Gorloth/all_yout_base_clock_control_board/control_board.kicad_pcb

## KiCad design control_board.kicad_pcb (2019-01-07)

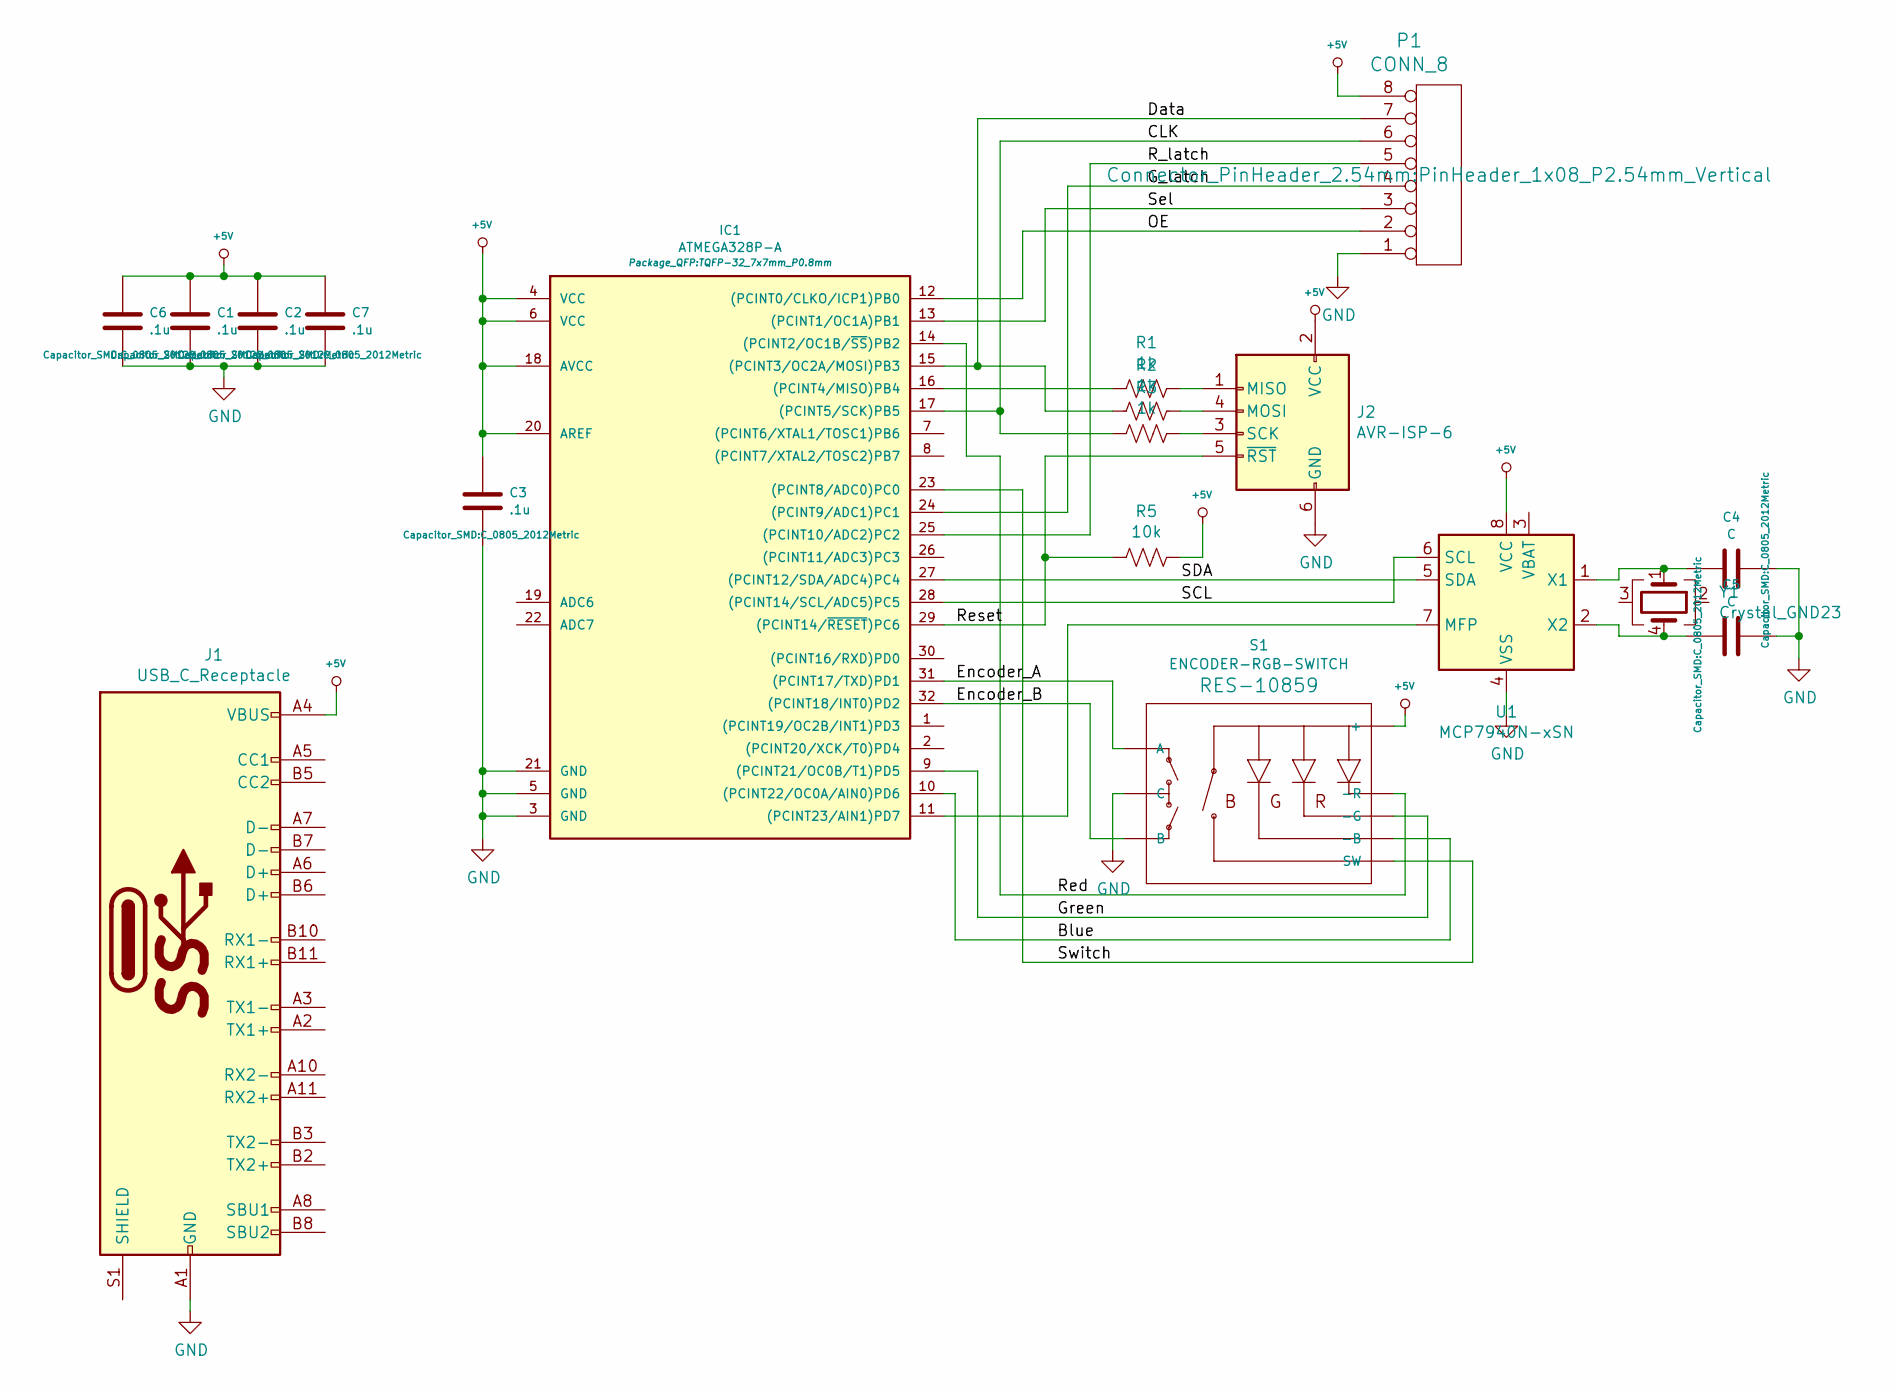
[picture p1: schematic control_board.sch]

Parts:
C1, C2, C3, C6, C7: .1u; C_0805_2012Metric
C4, C5: C; C_0805_2012Metric
IC1: ATMEGA328P-A; TQFP-32_7x7mm_P0.8mm
J1: USB_C_Receptacle; JAE_DX07S024XJ1R1100
J2: AVR-ISP-6; PinHeader_2x03_P2.54mm_Vertical
P1: CONN_8; PinHeader_1x08_P2.54mm_Vertical
R1, R2, R3: 1k; R_0805_2012Metric
R5: 10k; R_0805_2012Metric
S1: ENCODER-RGB-SWITCH; Encoder_w_switch_RGB_LED_SMD
U1: MCP7940N-xSN; SSOP-8_3.95x5.21x3.27mm_P1.27mm
Y1: Crystal_GND23; Crystal_SMD_SeikoEpson_MC146-4Pin_6.7x1.5mm_HandSoldering

Connections:
+5V: C1.1, C2.1, C3.1, C6.1, C7.1, IC1.4 (VCC), IC1.6 (VCC), IC1.18 (AVCC), IC1.20 (AREF), J1.A4 (VBUS), J1.A9 (VBUS), J1.B4 (VBUS), J1.B9 (VBUS), J2.2 (VCC), P1.8, R5.1, S1.5 (+), U1.8 (VCC)
/Blue: IC1.10 ((PCINT22/OC0A/AIN0)PD6), S1.4 (-B)
/CLK: IC1.17 ((PCINT5/SCK)PB5), P1.6, R3.2
/Data: IC1.15 ((PCINT3/OC2A/MOSI)PB3), P1.7, R2.2
/Encoder_A: IC1.31 ((PCINT17/TXD)PD1), S1.A
/Encoder_B: IC1.32 ((PCINT18/INT0)PD2), S1.B
/G_latch: IC1.24 ((PCINT9/ADC1)PC1), P1.4
/Green: IC1.9 ((PCINT21/OC0B/T1)PD5), S1.2 (-G)
/OE: IC1.12 ((PCINT0/CLKO/ICP1)PB0), P1.2
/R_latch: IC1.25 ((PCINT10/ADC2)PC2), P1.5
/Red: IC1.14 ((PCINT2/OC1B/~SS~)PB2), S1.1 (-R)
/Reset: IC1.29 ((PCINT14/~RESET~)PC6), J2.5 (~RST), R5.2
/SCL: IC1.28 ((PCINT14/SCL/ADC5)PC5), U1.6 (SCL)
/SDA: IC1.27 ((PCINT12/SDA/ADC4)PC4), U1.5 (SDA)
/Sel: IC1.13 ((PCINT1/OC1A)PB1), P1.3
/Switch: IC1.23 ((PCINT8/ADC0)PC0), S1.3 (SW)
GND: C1.2, C2.2, C3.2, C4.2, C5.1, C6.2, C7.2, IC1.3 (GND), IC1.5 (GND), IC1.21 (GND), J1.A1 (GND), J1.A12 (GND), J1.B1 (GND), J1.B12 (GND), J2.6 (GND), P1.1, S1.C, U1.4 (VSS)
unnamed: C4.1, U1.1 (X1), Y1.1
unnamed: C5.2, U1.2 (X2), Y1.4
unnamed: IC1.11 ((PCINT23/AIN1)PD7), U1.7 (MFP)
unnamed: IC1.16 ((PCINT4/MISO)PB4), R1.2
unnamed: J2.1 (MISO), R1.1
unnamed: J2.3 (SCK), R3.1
unnamed: J2.4 (MOSI), R2.1

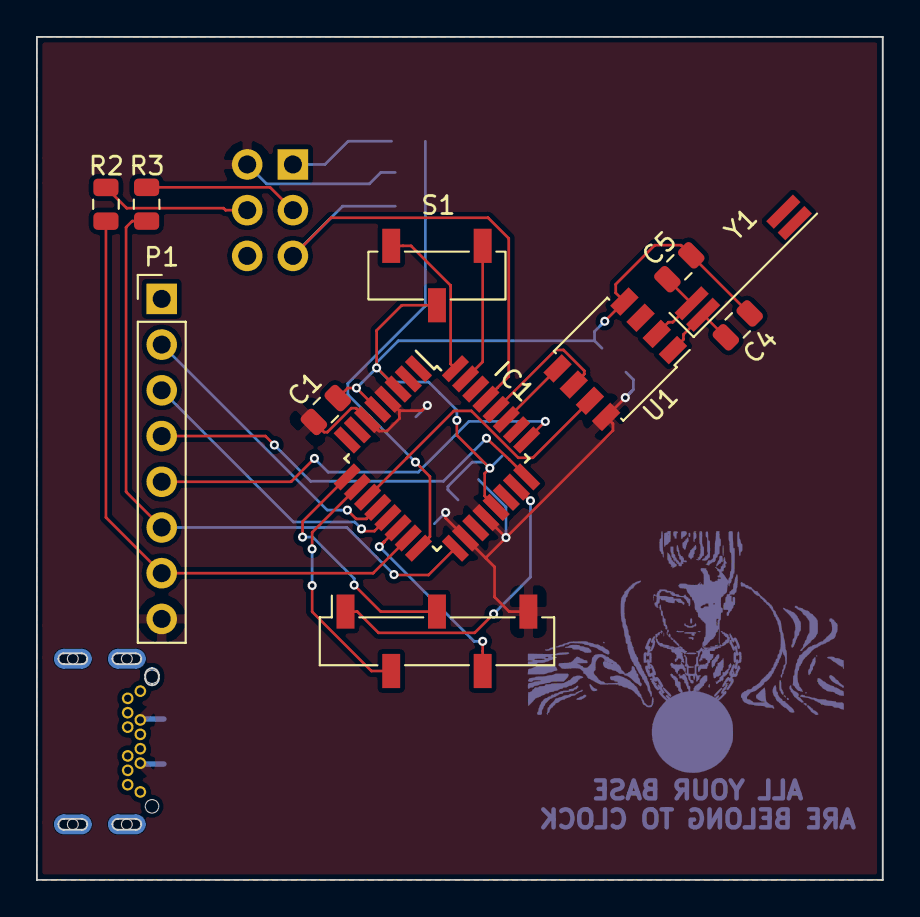
[picture p2: board control_board.kicad_pcb from above]

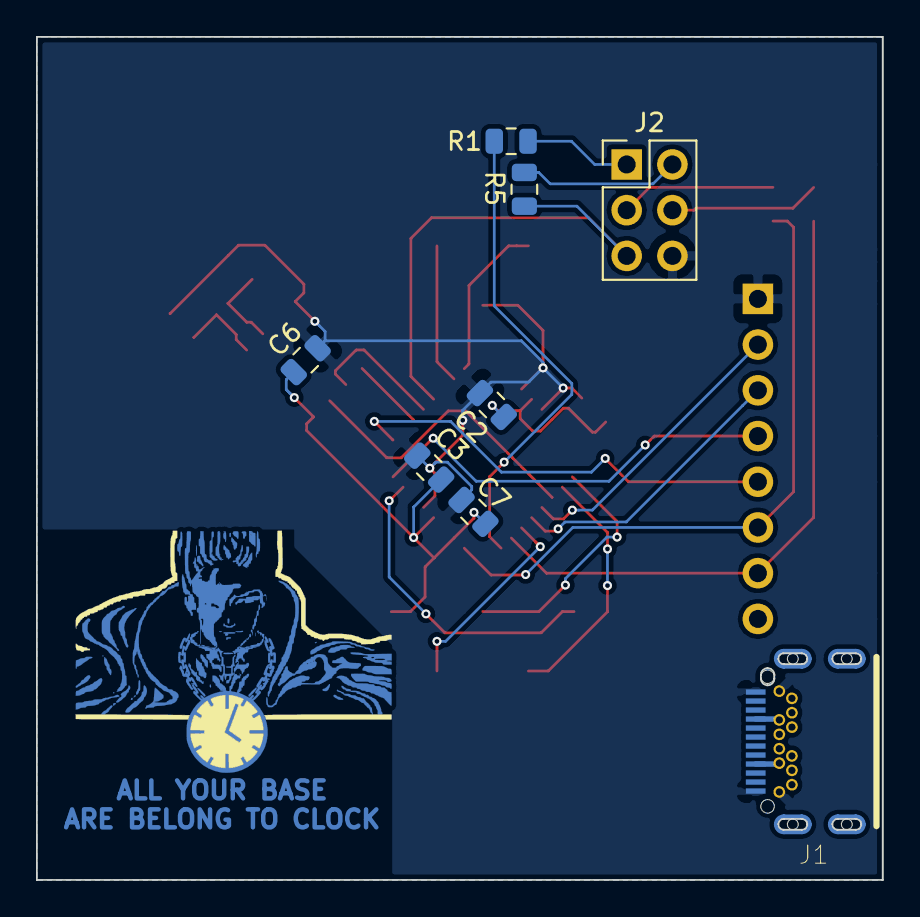
[picture p3: board control_board.kicad_pcb from below]

Board: 2 copper layers, 47.0 x 46.8 mm, 18 parts (8 on the bottom side), 24 nets.
