Gorloth/all_yout_base_clock_control_board/(commit log)

2019-01-06 Rev 1 of the control board
    [control_board-2018-11-14-07-14-50.sch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]
2019-01-07 Update for board rev 2
    Move USB connector to board edge
    Move resisters to not interfere with programming header
    Widen board to fit enclosure
    Move programming header and USB connector away from top/bottom of board for more clearance with enclosure
    Move red encoder LED to a PWM capable pin
    [control_board.kicad_pcb, control_board.sch]
